floppydisk525/AnilamToLinuxCNC/AnilamImagePower.PNG

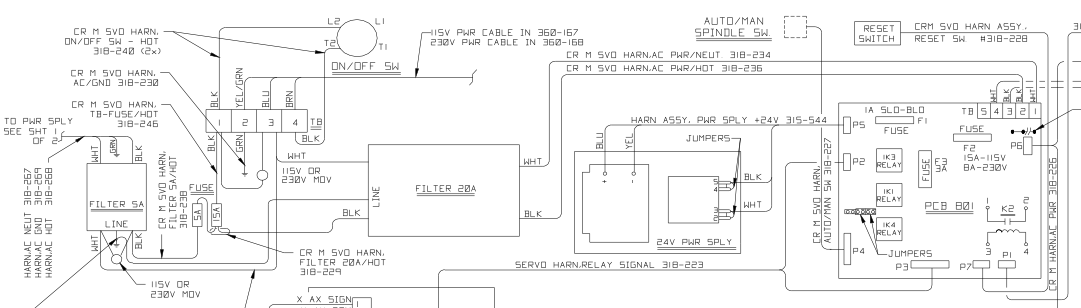
AnilamImagePower.PNG
