floppydisk525/AnilamToLinuxCNC/Project Files Image.PNG

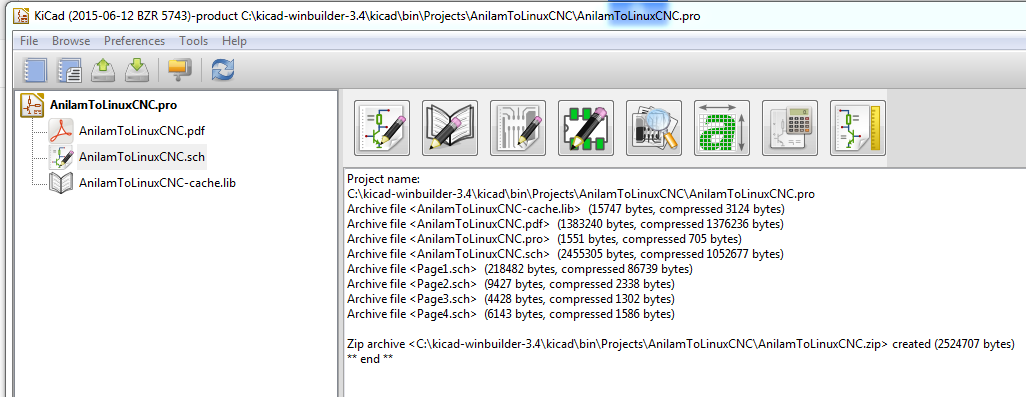
Project Files Image.PNG
