floppydisk525/AnilamToLinuxCNC/AnilamToLinuxCNC.pdf

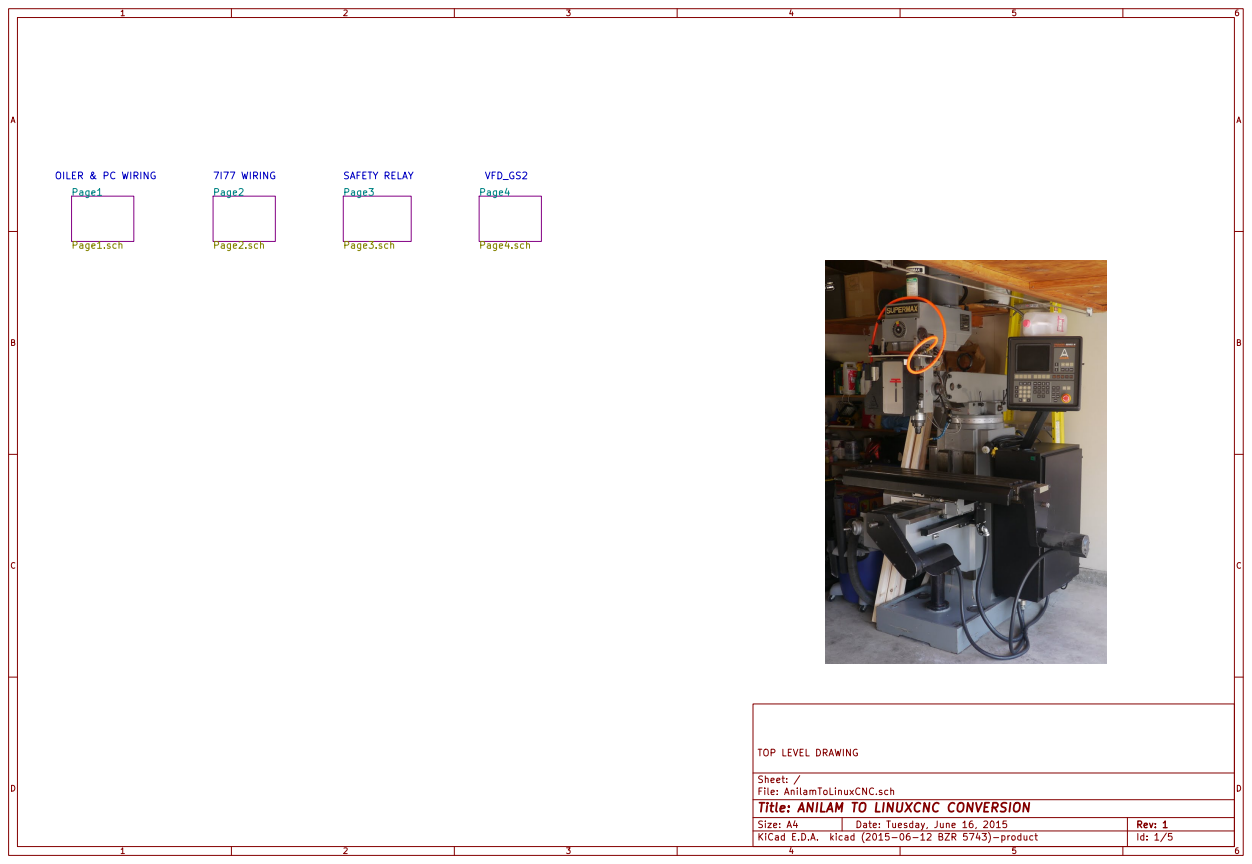
[picture p3: page 1]

File: AnilamToLinuxCNC.sch Sheet: / TOP LEVEL DRAWING

Id: 1/5 Title: ANILAM TO LINUXCNC CONVERSION

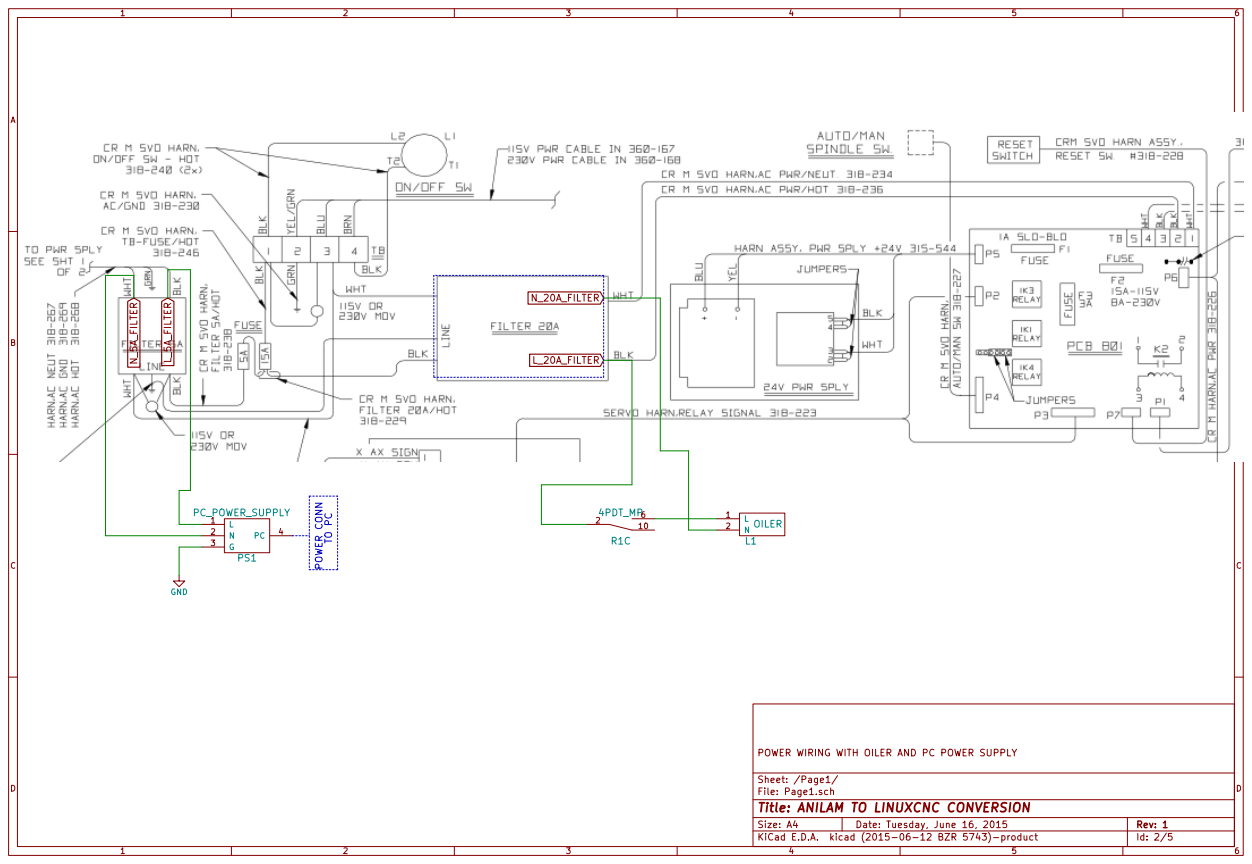
[picture p4: page 2]

Sheet: /Page1/ POWER WIRING WITH OILER AND PC POWER SUPPLY

File: Page1.sch
Id: 2/5 Title: ANILAM TO LINUXCNC CONVERSION

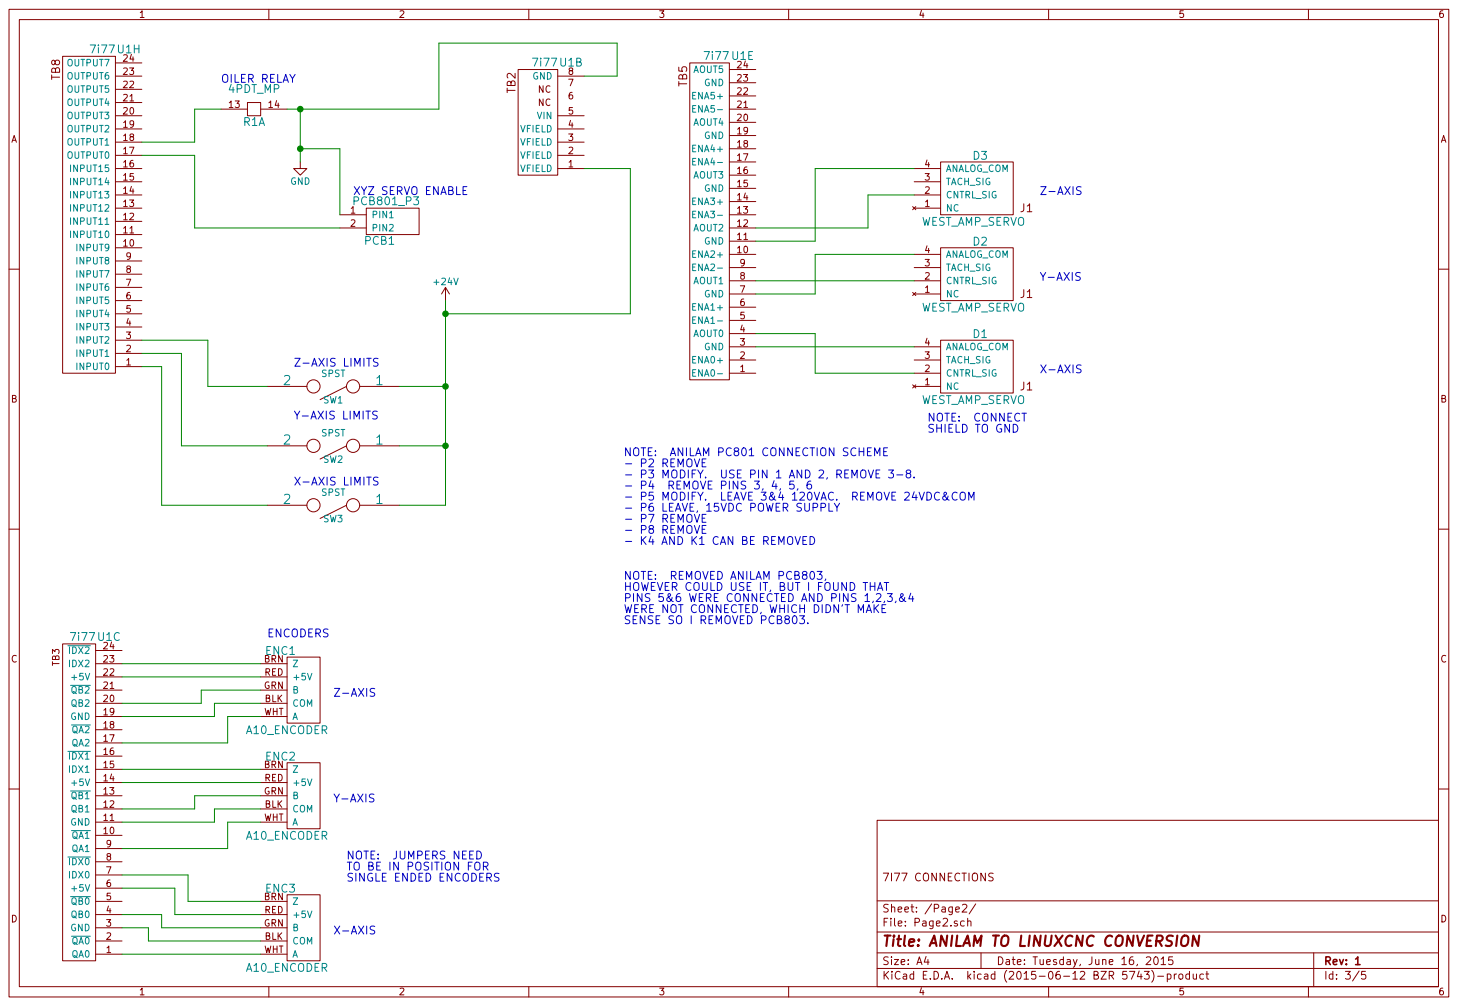
[picture p5: page 3]

NOTE: ANILAM PC801 CONNECTION SCHEME
- P2 REMOVE
- P4 REMOVE PINS 3, 4, 5, 6
- P6 LEAVE, 15VDC POWER SUPPLY
- P7 REMOVE
- P8 REMOVE
- K4 AND K1 CAN BE REMOVED

NOTE: REMOVED ANILAM PCB803,
HOWEVER COULD USE IT, BUT I FOUND THAT
PINS 5&6 WERE CONNECTED AND PINS 1,2,3,&4
WERE NOT CONNECTED, WHICH DIDN'T MAKE
SENSE SO I REMOVED PCB803.

NOTE: JUMPERS NEED
TO BE IN POSITION FOR
SINGLE ENDED ENCODERS

File: Page2.sch
Id: 3/5 Title: ANILAM TO LINUXCNC CONVERSION

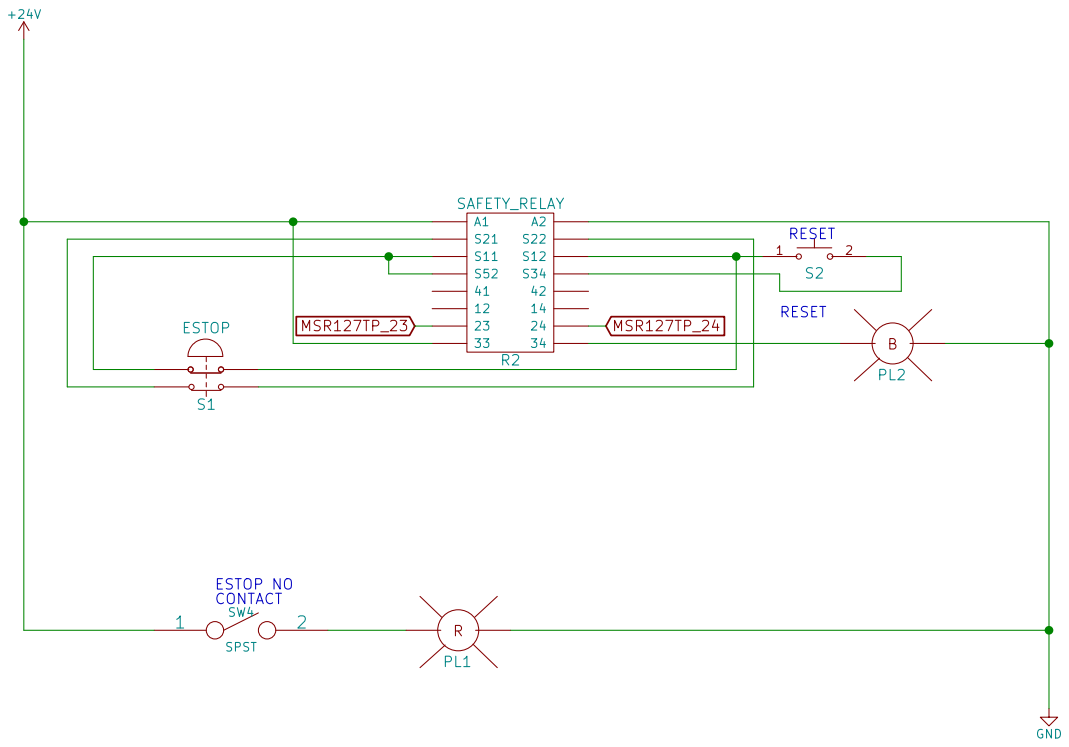
[picture p6: page 4]

Sheet: /Page3/ SAFETY RELAY LAYOUT

File: Page3.sch
Id: 4/5 Title: ANILAM TO LINUXCNC CONVERSION

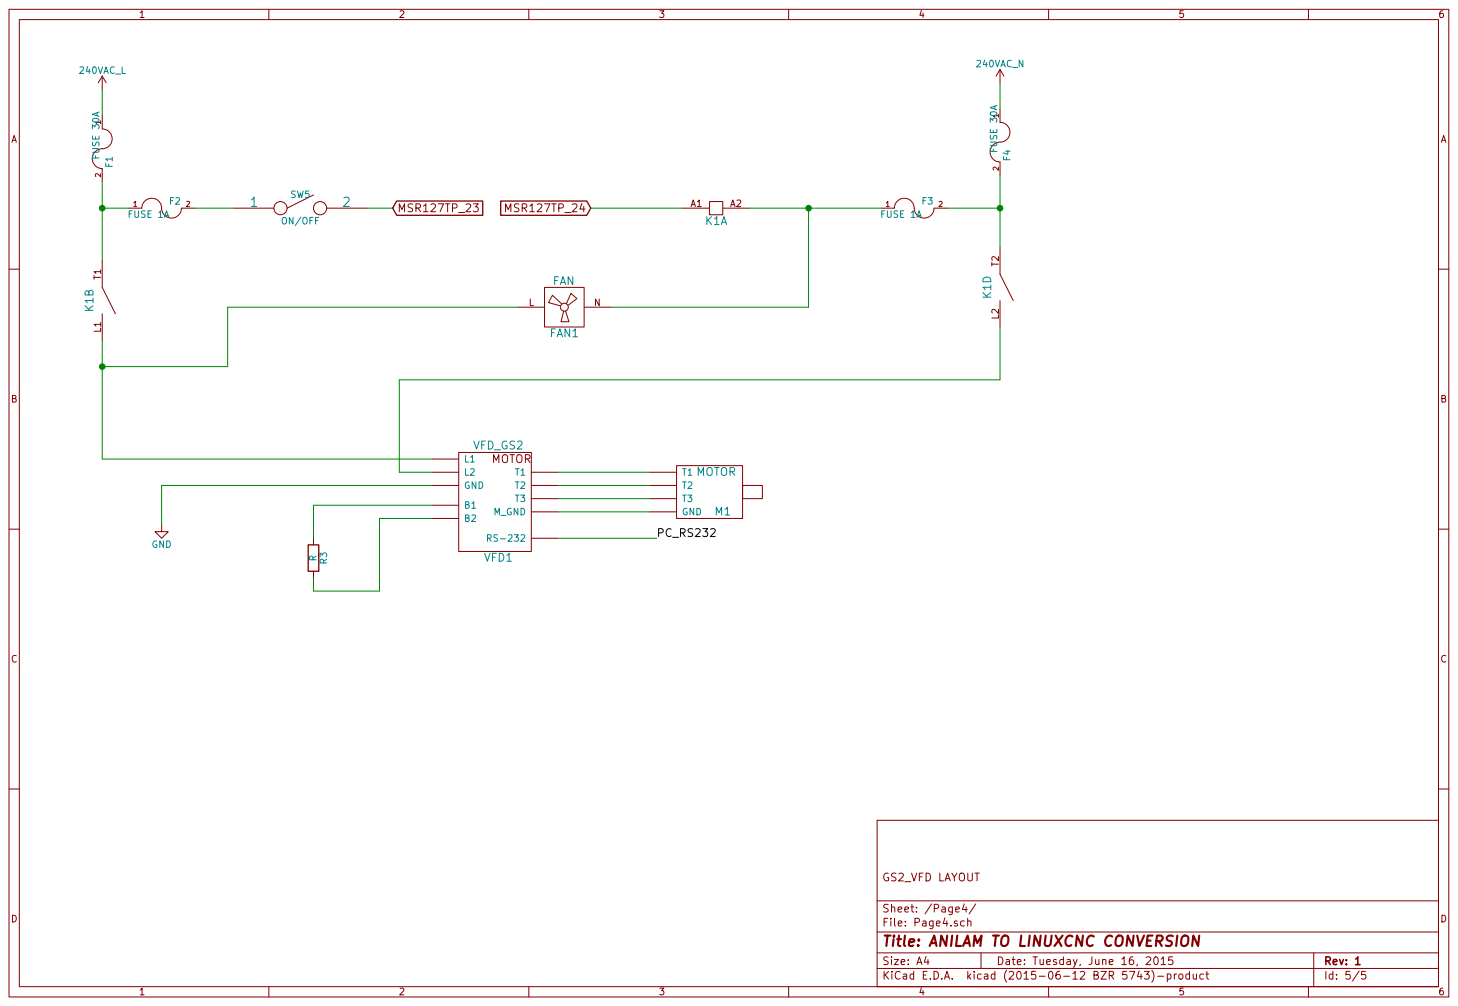
[picture p7: page 5]

Sheet: /Page4/
File: Page4.sch
Id: 5/5 Title: ANILAM TO LINUXCNC CONVERSION
