floppydisk525/AnilamToLinuxCNC/Page1.sch

## KiCad design Page1.sch (2015-06-17, last stored version)

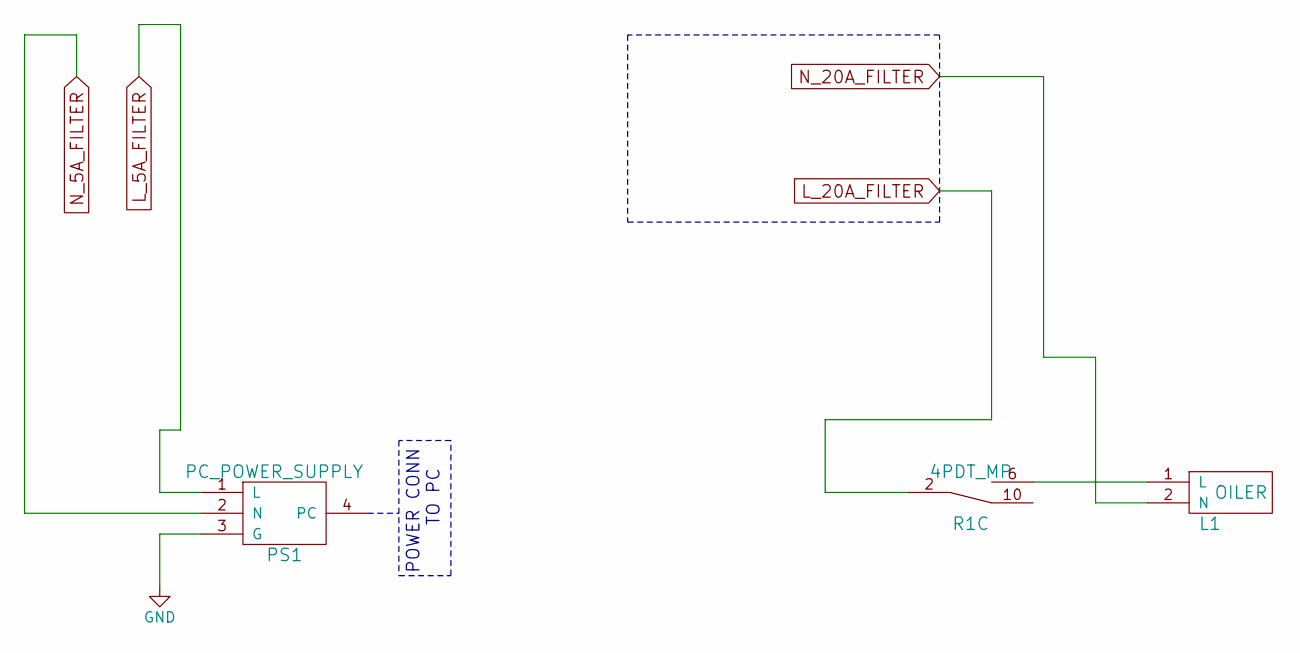
[picture p8: schematic Page1.sch]

Parts:
L1: OILER
PS1: PC_POWER_SUPPLY
R1: 4PDT_MP

Connections:
GND: PS1.3 (G)
L_5A_FILTER: PS1.1 (L)
L_20A_FILTER: R1.2
N_5A_FILTER: PS1.2 (N)
N_20A_FILTER: L1.2 (N)
unnamed: L1.1 (L), R1.6

Notes on the sheet:
POWER CONN TO PC
