floppydisk525/AnilamToLinuxCNC/Page2.sch

## KiCad design Page2.sch (2015-06-17, last stored version)

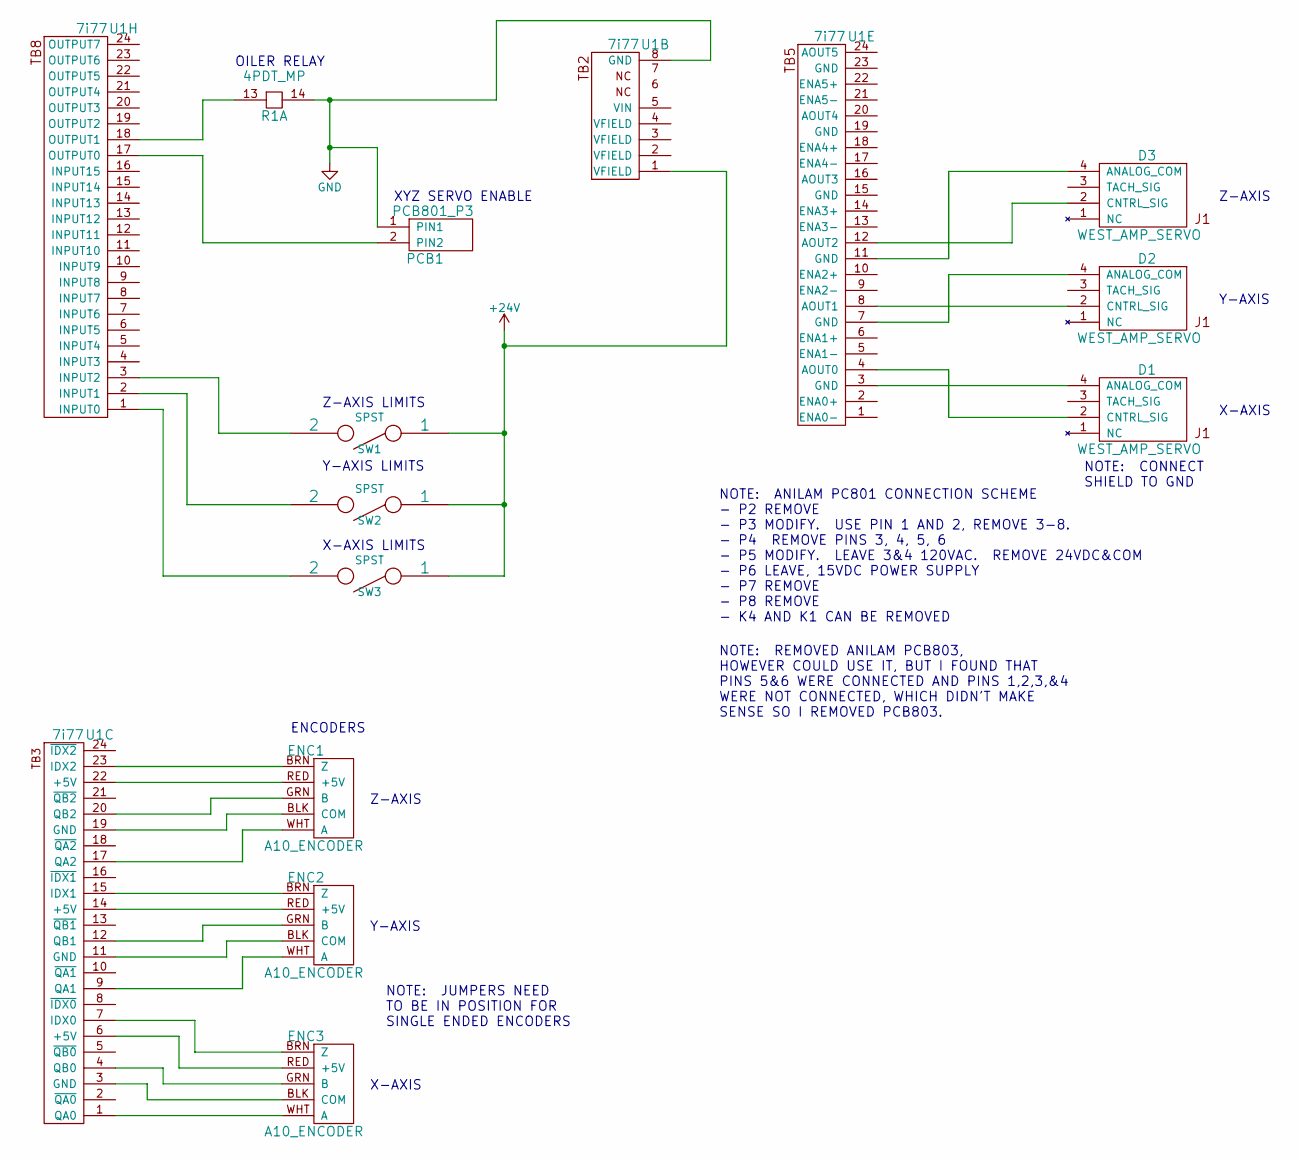
[picture p9: schematic Page2.sch]

Parts:
D1, D2, D3: WEST_AMP_SERVO
ENC1, ENC2, ENC3: A10_ENCODER
PCB1: PCB801_P3
R1: 4PDT_MP
SW1, SW2, SW3: SPST
U1: 7i77

Connections:
+24V: SW1.1, SW2.1, SW3.1, U1.1 (GND)
GND: PCB1.1 (PIN1), R1.14, U1.8 (GND)
unnamed: D1.2 (CNTRL_SIG), U1.4 (VFIELD)
unnamed: D1.4 (ANALOG_COM), U1.3 (VFIELD)
unnamed: D2.2 (CNTRL_SIG), U1.8 (GND)
unnamed: D2.4 (ANALOG_COM), U1.7 (IDX0)
unnamed: D3.2 (CNTRL_SIG), U1.12 (QB1)
unnamed: D3.4 (ANALOG_COM), U1.11 (GND)
unnamed: ENC1.BLK (COM), U1.19 (GND)
unnamed: ENC1.BRN (Z), U1.23 (IDX2)
unnamed: ENC1.GRN (B), U1.20 (QB2)
unnamed: ENC1.RED (+5V), U1.22 (+5V)
unnamed: ENC1.WHT (A), U1.17 (QA2)
unnamed: ENC2.BLK (COM), U1.11 (GND)
unnamed: ENC2.BRN (Z), U1.15 (IDX1)
unnamed: ENC2.GRN (B), U1.12 (QB1)
unnamed: ENC2.RED (+5V), U1.14 (+5V)
unnamed: ENC2.WHT (A), U1.9 (QA1)
unnamed: ENC3.BLK (COM), U1.3 (VFIELD)
unnamed: ENC3.BRN (Z), U1.7 (IDX0)
unnamed: ENC3.GRN (B), U1.4 (VFIELD)
unnamed: ENC3.RED (+5V), U1.6 (+5V)
unnamed: ENC3.WHT (A), U1.1 (GND)
unnamed: PCB1.2 (PIN2), U1.17 (QA2)
unnamed: R1.13, U1.18 (~QA2)
unnamed: SW1.2, U1.3 (VFIELD)
unnamed: SW2.2, U1.2 (+5v)
unnamed: SW3.2, U1.1 (GND)

Notes on the sheet:
X-AXIS LIMITS
Y-AXIS LIMITS
Z-AXIS LIMITS
NOTE: CONNECT SHIELD TO GND
NOTE: JUMPERS NEED TO BE IN POSITION FOR SINGLE ENDED ENCODERS
NOTE: ANILAM PC801 CONNECTION SCHEME - P2 REMOVE - P3 MODIFY. USE PIN 1 AND 2, REMOVE 3-8. - P4 REMOVE PINS 3, 4, 5, 6 - P5 MODIFY. LEAVE 3&4 120VAC. REMOVE 24VDC&COM - P6 LEAVE, 15VDC POWER SUPPLY - P7 REMOVE - P8 REMOVE - K4 AND K1 CAN BE REMOVED
OILER RELAY
XYZ SERVO ENABLE
ENCODERS
NOTE: REMOVED ANILAM PCB803, HOWEVER COULD USE IT, BUT I FOUND THAT PINS 5&6 WERE CONNECTED AND PINS 1,2,3,&4 WERE NOT CONNECTED, WHICH DIDN'T MAKE SENSE SO I REMOVED PCB803.
X-AXIS
Y-AXIS
Z-AXIS
