floppydisk525/AnilamToLinuxCNC/Page3.sch

## KiCad design Page3.sch (2015-06-17, last stored version)

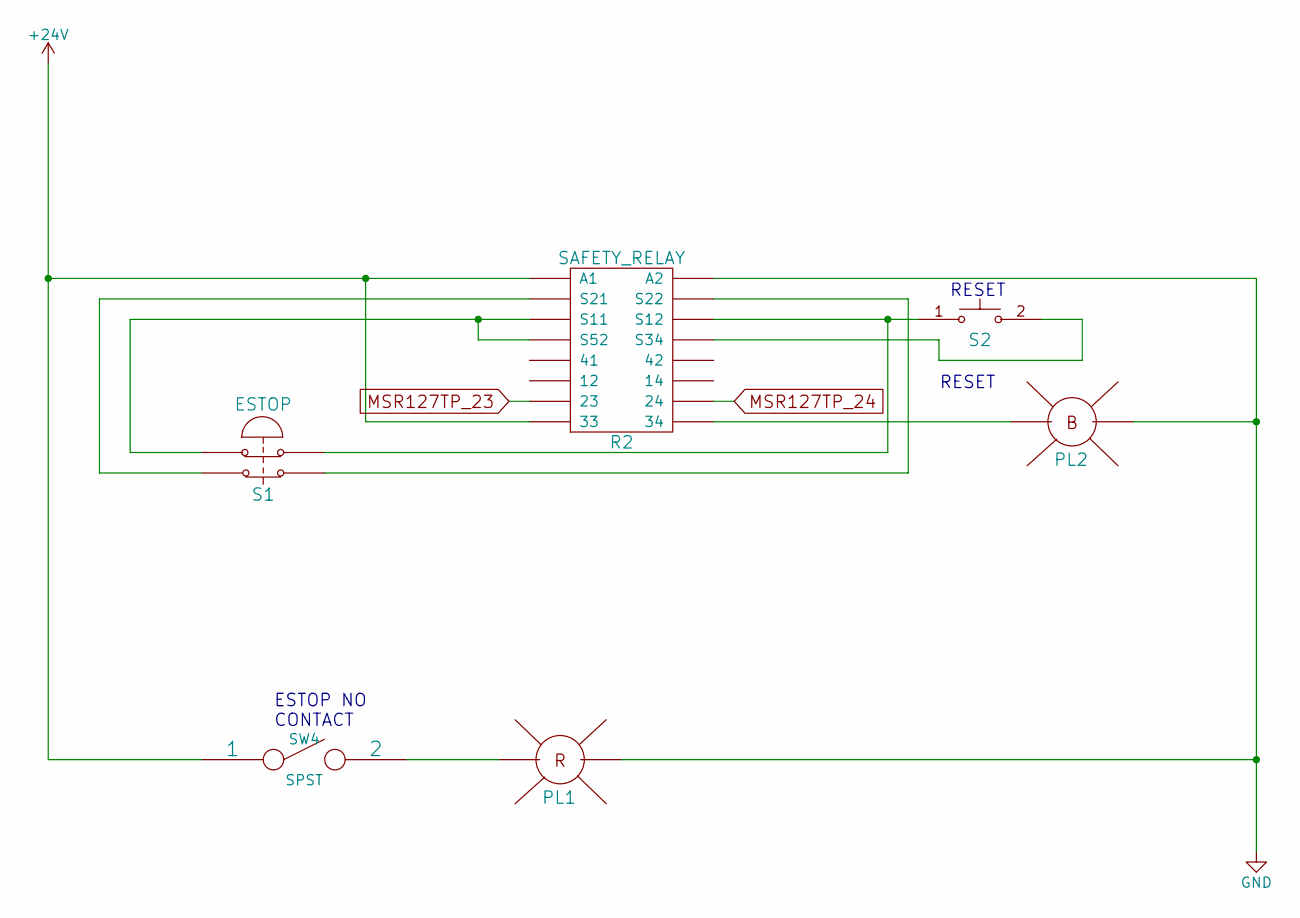
[picture p10: schematic Page3.sch]

Parts:
PL1: PILOT_Light_R
PL2: PILOT_Light_B
R2: SAFETY_RELAY
S1: ESTOP
S2: PB_SWTICH
SW4: SPST

Connections:
+24V: R2.1 (A1), R2.8 (33), SW4.1
GND: PL1.2, PL2.2, R2.9 (A2)
MSR127TP_23: R2.7 (23)
MSR127TP_24: R2.15 (24)
unnamed: PL1.1, SW4.2
unnamed: PL2.1, R2.16 (34)
unnamed: R2.2 (S21), S1.3
unnamed: R2.3 (S11), R2.4 (S52), S1.1
unnamed: R2.10 (S22), S1.4
unnamed: R2.11 (S12), S1.2, S2.1
unnamed: R2.12 (S34), S2.2

Notes on the sheet:
ESTOP NO CONTACT
RESET
