floppydisk525/AnilamToLinuxCNC/Page4.sch

## KiCad design Page4.sch (2015-06-17, last stored version)

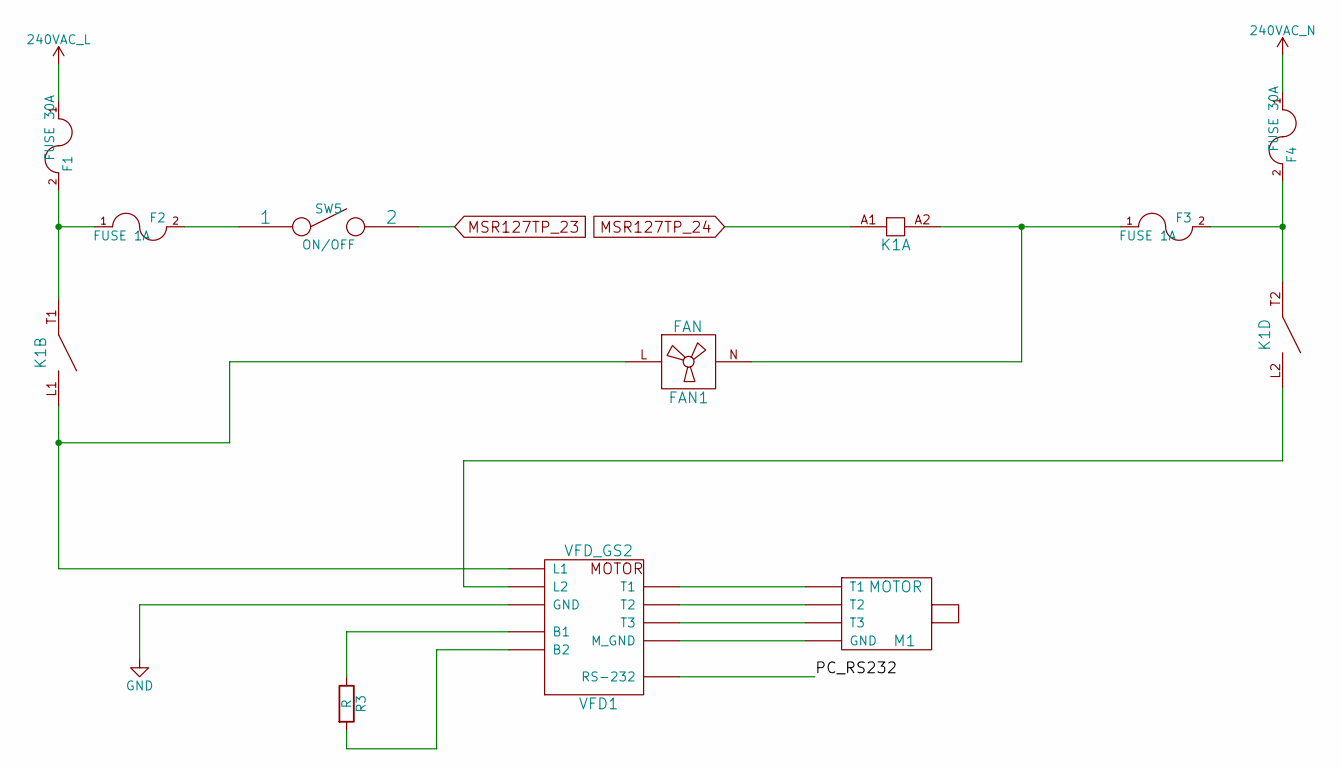
[picture p11: schematic Page4.sch]

Parts:
F1, F4: FUSE 30A
F2, F3: FUSE 1A
FAN1: FAN
K1: Contactor_3NO,_1NC_T1_MP
M1: MOTOR
R3: R
SW5: ON/OFF
VFD1: VFD_GS2

Connections:
240VAC_L: F1.1
240VAC_N: F4.1
GND: VFD1.3 (GND)
MSR127TP_23: SW5.2
MSR127TP_24: K1.A1
unnamed: F1.2, F2.1, K1.T1
unnamed: F2.2, SW5.1
unnamed: F3.1, FAN1.N, K1.A2
unnamed: F3.2, F4.2, K1.T2
unnamed: FAN1.L, K1.L1, VFD1.1 (L1)
unnamed: K1.L2, VFD1.2 (L2)
unnamed: M1.1 (T1), VFD1.T1
unnamed: M1.2 (T2), VFD1.T2
unnamed: M1.3 (T3), VFD1.T3
unnamed: M1.4 (GND), VFD1.4 (M_GND)
unnamed: R3.1, VFD1.B1
unnamed: R3.2, VFD1.B2
PC_RS232: VFD1.5 (RS-232)
