floppydisk525/AnilamToLinuxCNC/(commit log)

2015-06-17 Check-in Files
    Initial check-in of files.
    [AnilamToLinuxCNC.sch, Page1.sch, Page2.sch, Page3.sch, Page4.sch]
2015-06-17 Add Archive/Zip file of Project
    Possibly, to help download everything I've included an archive out of
    KiCAD that includes all the req'd files. It also has a 'cache.lib' that
    I assume includes all the components to build the schematics properly.
2015-06-18 Removed individual, use zip file
    The individual files apparently don't work and the zip file needs to be
    downloaded. therefore, I deleted the individual files.
    [AnilamToLinuxCNC.sch, Page1.sch, Page2.sch, Page3.sch, Page4.sch]
